vluncasu/via-oneplus-pad-terminal/docs/part-catalog.md

# Printable Part Catalog

Parts, quantities and filament groups for the R14.1 enclosure. Bounds are X × Y × Z in the **supplied STL print orientation**, not assembly dimensions. Numbers are rounded to two decimals. Quantity is the total copies of the one file; reference objects R01–R05 are excluded.

| Required color group | Unique files | Printed pieces |
|---|---:|---:|
| white PETG | 12 | 25 |
| black PETG | 4 | 4 |
| natural PETG | 1 | 1 |

## Required components

| IDs | Part / file | Copies | Filament | Supplied STL bounds (mm) |
|---|---|---:|---|---|
| B01 | [monoblock base integrated light belt](../hardware/print/white-petg/01x_B01_monoblock_base_integrated_light_belt.stl) | 1 | white PETG | 190.21 × 190.21 × 230.00 |
| B03 | [bottom service cover](../hardware/print/white-petg/01x_B03_bottom_service_cover.stl) | 1 | white PETG | 157.26 × 157.26 × 209.40 |
| B07 | [integrated s stand and power supply cover](../hardware/print/white-petg/01x_B07_integrated_s_stand_and_power_supply_cover.stl) | 1 | white PETG | 240.00 × 230.00 × 197.00 |
| P01 | [recessed dummy port cartridge and cable funnel](../hardware/print/black-petg/01x_P01_recessed_dummy_port_cartridge_and_cable_funnel.stl) | 1 | black PETG | 180.00 × 19.99 × 14.00 |
| H01 | [structural front frame integrated led channel](../hardware/print/white-petg/01x_H01_structural_front_frame_integrated_led_channel.stl) | 1 | white PETG | 242.75 × 242.75 × 224.00 |
| H04 | [lower structural rear cover](../hardware/print/white-petg/01x_H04_lower_structural_rear_cover.stl) | 1 | white PETG | 221.61 × 221.61 × 187.55 |
| O01 | [open optical carrier](../hardware/print/black-petg/01x_O01_open_optical_carrier.stl) | 1 | black PETG | 26.00 × 194.00 × 29.80 |
| O03 | [optical carrier usb service cover](../hardware/print/black-petg/01x_O03_optical_carrier_usb_service_cover.stl) | 1 | black PETG | 34.60 × 202.60 × 7.00 |
| V21, V22, V23, V24 | [head mount screw D12 P2p5 L12](../hardware/print/white-petg/04x_V21-V22-V23-V24_head_mount_screw_D12_P2p5_L12.stl) | 4 | white PETG | 18.71 × 18.72 × 16.00 |
| V31, V32, V33, V34 | [spherical slotted screw foot D8](../hardware/print/white-petg/04x_V31-V32-V33-V34_spherical_slotted_screw_foot_D8.stl) | 4 | white PETG | 23.23 × 23.23 × 20.00 |
| V41, V42, V43, V44 | [base cover screw D8 P2p5 L10](../hardware/print/white-petg/04x_V41-V42-V43-V44_base_cover_screw_D8_P2p5_L10.stl) | 4 | white PETG | 12.48 × 12.48 × 14.00 |
| V51, V52, V53, V54 | [rear cover screw D8 P2p5 L14](../hardware/print/white-petg/04x_V51-V52-V53-V54_rear_cover_screw_D8_P2p5_L14.stl) | 4 | white PETG | 12.48 × 12.48 × 18.00 |
| V61, V62 | [usb cover screw D8 P2p5 L16p3](../hardware/print/white-petg/02x_V61-V62_usb_cover_screw_D8_P2p5_L16p3.stl) | 2 | white PETG | 12.48 × 12.48 × 20.30 |
| H05 | [sliding top tablet retention bar](../hardware/print/white-petg/01x_H05_sliding_top_tablet_retention_bar.stl) | 1 | white PETG | 195.16 × 195.16 × 8.30 |
| O05 | [captive optical film 0p20mm](../hardware/print/natural-petg/01x_O05_captive_optical_film_0p20mm.stl) | 1 | natural PETG | 25.60 × 193.60 × 0.20 |
| H06 | [upper rear service cover integrated locking pins](../hardware/print/white-petg/01x_H06_upper_rear_service_cover_integrated_locking_pins.stl) | 1 | white PETG | 236.58 × 236.58 × 34.20 |
| O06 | [flat back dummy sensor face](../hardware/print/black-petg/01x_O06_flat_back_dummy_sensor_face.stl) | 1 | black PETG | 26.00 × 194.00 × 3.00 |

## Optional low-material probes

| IDs | Part / file | Copies | Filament | Supplied STL bounds (mm) |
|---|---|---:|---|---|
| Q12 | [usb plug pull through gauge 16x10x30](../hardware/print/optional-probes/01x_Q12_usb_plug_pull_through_gauge_16x10x30.stl) | 1 | white PETG | 16.00 × 10.00 × 30.00 |
| Q01 | [D12 thread test screw](../hardware/print/optional-probes/01x_Q01_D12_thread_test_screw.stl) | 1 | white PETG | 18.71 × 18.72 × 16.00 |
| Q02 | [D12 nut clearance 0p25](../hardware/print/optional-probes/01x_Q02_D12_nut_clearance_0p25.stl) | 1 | white PETG | 19.99 × 20.00 × 10.00 |
| Q03 | [D12 nut clearance 0p35](../hardware/print/optional-probes/01x_Q03_D12_nut_clearance_0p35.stl) | 1 | white PETG | 19.99 × 20.00 × 10.00 |
| Q04 | [D12 nut clearance 0p45](../hardware/print/optional-probes/01x_Q04_D12_nut_clearance_0p45.stl) | 1 | white PETG | 19.99 × 20.00 × 10.00 |
| Q05 | [D8 thread test screw](../hardware/print/optional-probes/01x_Q05_D8_thread_test_screw.stl) | 1 | white PETG | 12.48 × 12.48 × 14.00 |
| Q06 | [D8 nut clearance 0p30](../hardware/print/optional-probes/01x_Q06_D8_nut_clearance_0p30.stl) | 1 | white PETG | 13.99 × 14.00 × 8.00 |
| Q07 | [tablet corner fit coupon](../hardware/print/optional-probes/01x_Q07_tablet_corner_fit_coupon.stl) | 1 | white PETG | 30.00 × 30.00 × 9.00 |
| Q11 | [front camera clearance coupon](../hardware/print/optional-probes/01x_Q11_front_camera_clearance_coupon.stl) | 1 | white PETG | 40.00 × 17.89 × 8.30 |
| Q08 | [light transmission wall 0p6](../hardware/print/optional-probes/01x_Q08_light_transmission_wall_0p6.stl) | 1 | white PETG | 25.00 × 15.00 × 0.60 |
| Q09 | [light transmission wall 0p8](../hardware/print/optional-probes/01x_Q09_light_transmission_wall_0p8.stl) | 1 | white PETG | 25.00 × 15.00 × 0.80 |
| Q10 | [light transmission wall 1p0](../hardware/print/optional-probes/01x_Q10_light_transmission_wall_1p0.stl) | 1 | white PETG | 25.00 × 15.00 × 1.00 |
| Q13 | [tablet width gauge 259p03](../hardware/print/optional-probes/01x_Q13_tablet_width_gauge_259p03.stl) | 1 | white PETG | 200.13 × 200.13 × 11.00 |
| Q14 | [tablet height gauge 190p41](../hardware/print/optional-probes/01x_Q14_tablet_height_gauge_190p41.stl) | 1 | white PETG | 151.61 × 151.61 × 11.00 |
| Q15 | [led channel corner coupon 8p5](../hardware/print/optional-probes/01x_Q15_led_channel_corner_coupon_8p5.stl) | 1 | white PETG | 29.00 × 24.00 × 14.00 |

## Alternatives and reference envelopes

O05 0.40 mm is an optional replacement for the 0.20 mm default, not an extra required piece. R01 tablet, R02 supply, R03 USB plug and R04/R05 LED volumes are inspection references, not printable hardware.

White PETG: structural pieces and printed fasteners. Black PETG: P01, O01, O03 and O06. Natural PETG: O05. The present rigid feet are not TPU pads.

## Reading the file families

- B: base / stand and service enclosure.
- H: structural head and tablet retention.
- O: optical cassette, service cover, sensor face and film.
- P: one-piece dummy port cartridge.
- V: printed screw / foot instances.
- Q: optional fit and process probes.
- R: reference envelopes, never a print quantity.

Use [fasteners and service](fasteners-and-service.md) for the receiving interface of each V family, [manufacturing workflow](manufacturing-workflow.md) before large prints, and [assembly](assembly.md) for the build order.

This catalog is a file-selection aid. Its bounds and closed-mesh results do not qualify strength, fit, supports or optical performance.
