vluncasu/via-oneplus-pad-terminal/docs/references.md

# Sources and Attribution

Project-specific dimensions come from the delivered R14 CAD/print inventory unless explicitly identified as a manufacturer specification or provisional envelope.

1. [OnePlus Pad specifications](https://www.oneplus.com/ca_en/oneplus-pad/specs): nominal tablet body dimensions. This project is not affiliated with OnePlus.
2. [Bambu Lab P1 series technical specifications](https://bambulab.com/en/p1/tech-specs) and [print-volume limitations](https://wiki.bambulab.com/en/knowledge-sharing/print-volume-limitations): nominal build volume and practical exclusions; availability can vary by region.
3. [Android Bluetooth permissions](https://developer.android.com/develop/connectivity/bluetooth/bt-permissions): runtime permissions and Android-version differences.
4. [MediaPipe Hand Landmarker](https://developers.google.com/edge/mediapipe/solutions/vision/hand_landmarker): hand landmarks and handedness; not proof of financial identity.
5. [MediaPipe Hands paper](https://arxiv.org/abs/2006.10214): pipeline context.
6. [ML Kit face detection concepts](https://developers.google.com/ml-kit/vision/face-detection/face-detection-concepts): face features, classification and tracking context.
7. [MediaPipe license](https://github.com/google-ai-edge/mediapipe/blob/master/LICENSE), [Android/ML Kit terms](https://developers.google.com/ml-kit/terms), and the notices of each dependency apply independently.

The repository consolidates the project source, design artifacts and scoped verification evidence. The design rationale is a prototype engineering report, not a published experimental study; it does not claim a DOI, institutional certification or unmeasured performance. Attribution is to VIA project contributors and the repository owner, vluncasu.
