vluncasu/via-oneplus-pad-terminal/docs/gallery-engineering.md

# Internal Structure, Assembly and Service Views

All figures use the supplied actual component meshes. Materials and intended LED emission are illustrative. Orange objects are non-printable reference envelopes. Covers omitted and section cuts are stated per figure; they do not alter the STL files. The normal [assembled Blender scene](../media/via-oneplus-pad-r14-1-assembled.blend) remains separate.

[Gallery index](gallery.md) · [Documentation](README.md)

## Figure 04 — Base body and recessed ports

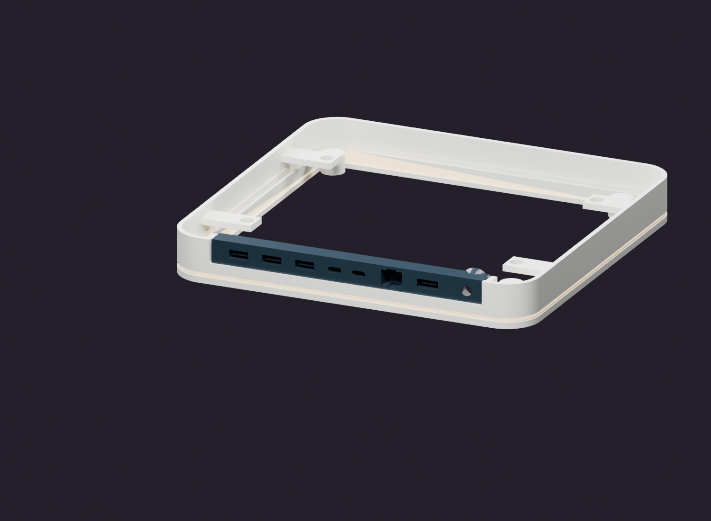
[picture p11: media/renders/04-recessed-dummy-usb-ethernet-ports.png]
Base body and recessed ports


B01 and P01 only; upper cover/stand omitted to show how the cartridge sits within the outer base.

## Figure 06 — Upper retention bar and service cover

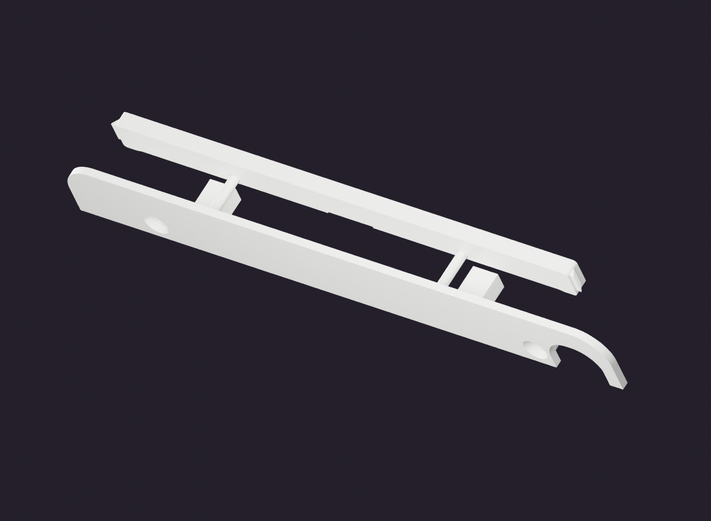
[picture p12: media/renders/06-top-service-locking-bar.png]
Upper retention bar and service cover


H05/H06 isolated at their assembled positions. The integrated pins belong to H06; there is no loose miniature lock pin.

## Figure 07 — Integrated head LED channel

Integrated head LED channel

H01 with R05 orange reserved LED volume. The orange object is not a printable strip or a verified bend solution.

## Figure 08 — Integrated base LED channel

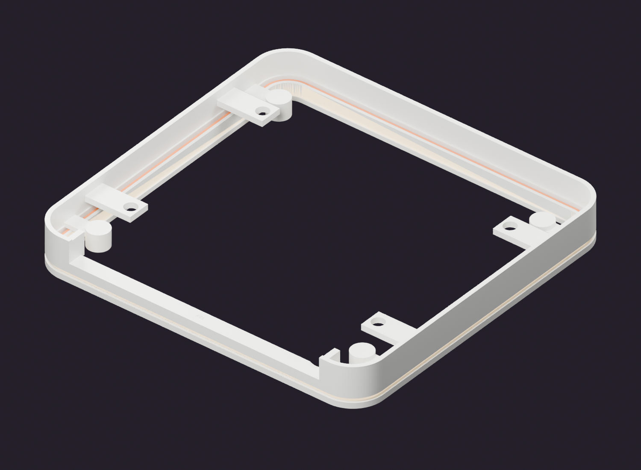
[picture p13: media/renders/08-integrated-base-led-channel.png]
Integrated base LED channel


B01 with R04 orange reserved LED volume; integrated seating and rim geometry are visible.

## Figure 09 — Stand-root underside

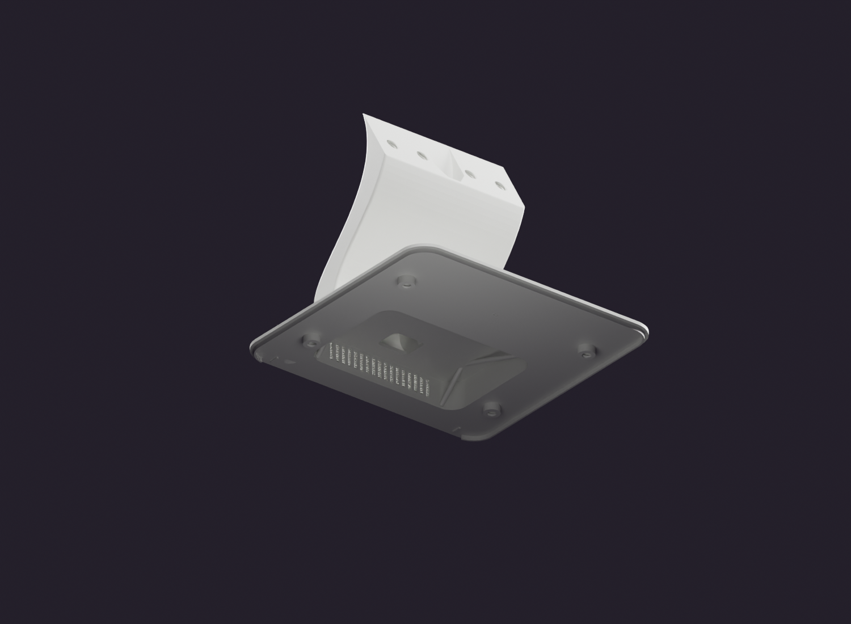
[picture p14: media/renders/09-stand-root-reinforcement.png]
Stand-root underside


B07 viewed from below with inspection fill lighting; cover, duct opening and root material are the actual supplied shape.

## Figure 10 — Internal cable duct section

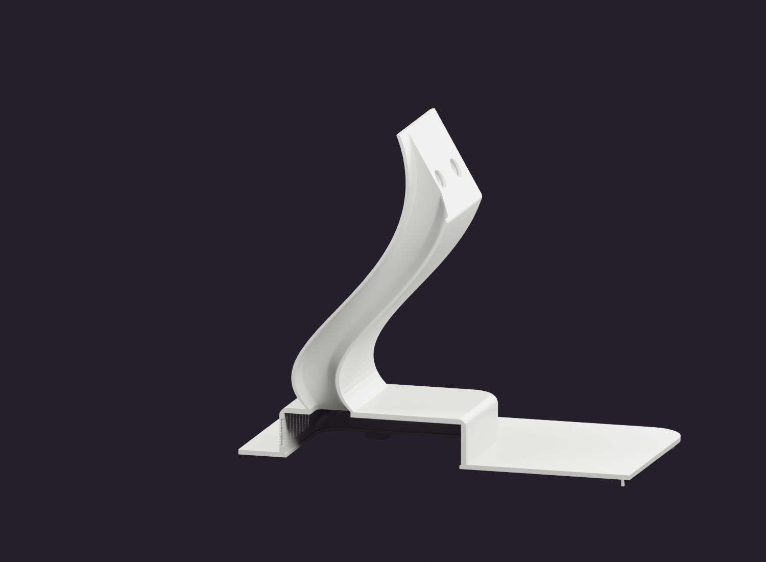
[picture p15: media/renders/10-internal-cable-duct-section.png]
Internal cable duct section


One side of B07 is removed only for this inspection view. The printable stand remains a single piece.

## Figure 20 — Head with rear covers omitted

Head with rear covers omitted

H01, nominal R01 tablet envelope, optical parts, H05 and head screws remain. H04/H06 omitted for seating inspection.

## Figure 21 — Rear covers and top restraint

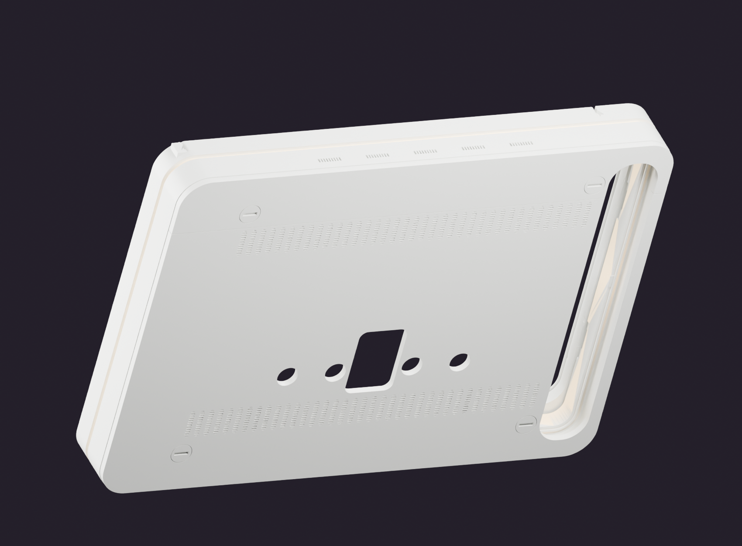
[picture p16: media/renders/21-rear-cover-and-retention-assembly.png]
Rear covers and top restraint


H01/H04/H05/H06 with rear screws in assembly coordinates. Tablet and optical cassette omitted.

## Figure 22 — Base underside and supply envelope

Base underside and supply envelope

B01/B07/P01 with orange R02 body envelope; bottom service cover omitted. R02 is not a detailed supply or a clearance qualification.

## Figure 23 — Stand root beside supply envelope

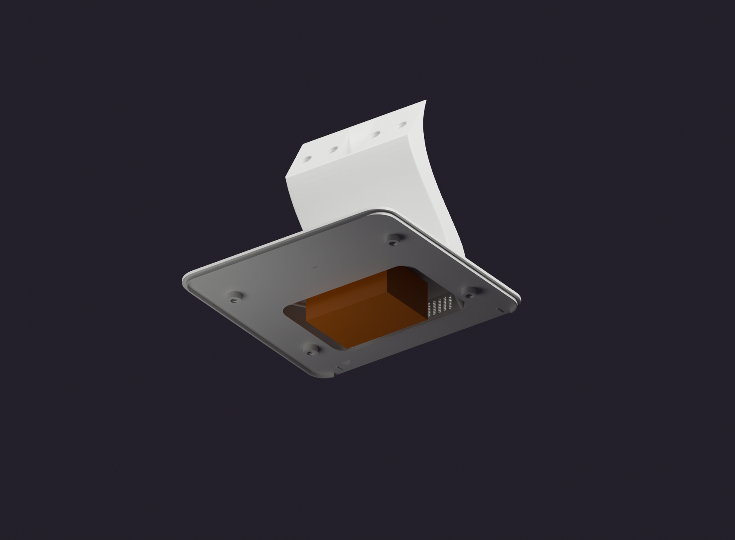
[picture p17: media/renders/23-stand-root-supply-clearance.png]
Stand root beside supply envelope


B07 and orange R02 only. The root braces belong to the stand, not the supply. Terminal/wiring/cooling clearance still needs the real component.

## Figure 24 — Bottom service cover, screws and feet

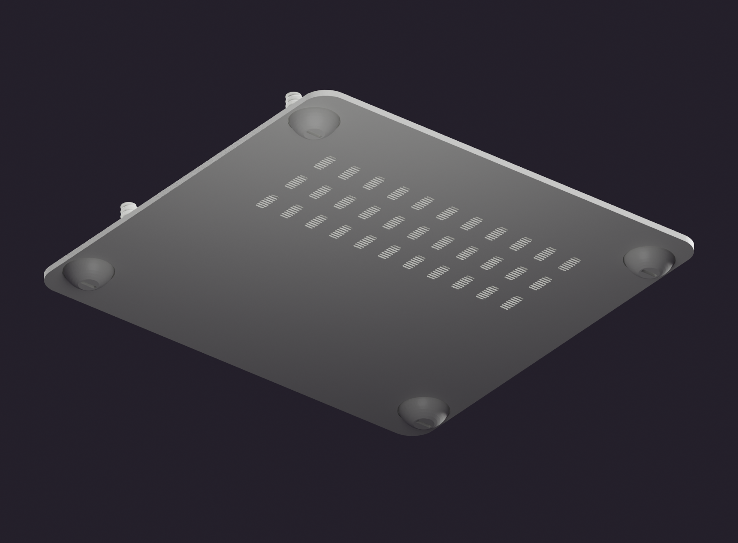
[picture p18: media/renders/24-bottom-service-cover-fasteners.png]
Bottom service cover, screws and feet


B03 with V41–V44 and V31–V34 in their assembled positions; base and upper cover omitted.

## Figure 29 — Tablet retention components

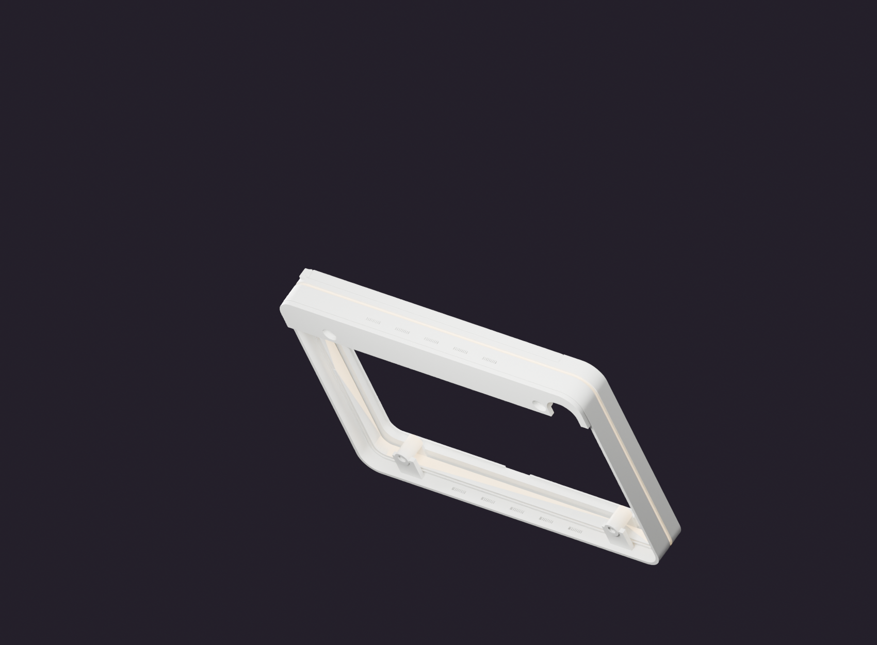
[picture p19: media/renders/29-tablet-retention-interface.png]
Tablet retention components


H01/H05/H06 isolated in assembly coordinates to relate the guide bar to the upper service cover.

## Figure 30 — Opposite stand-duct section

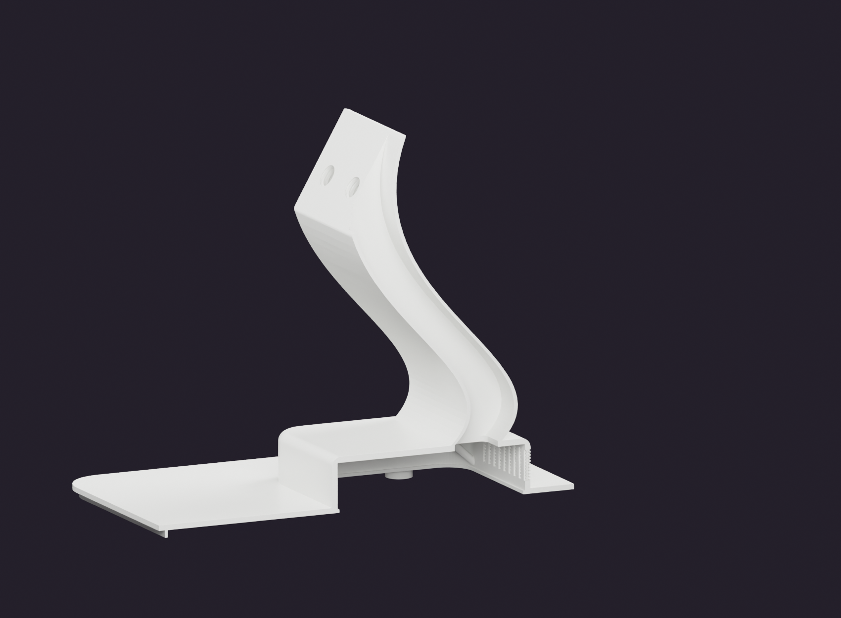
[picture p20: media/renders/30-cable-duct-opposite-section.png]
Opposite stand-duct section


Opposite half-section of B07. This inspection-only subtraction is not part of the manufacturing files.

## Figure 31 — Structural head from the front

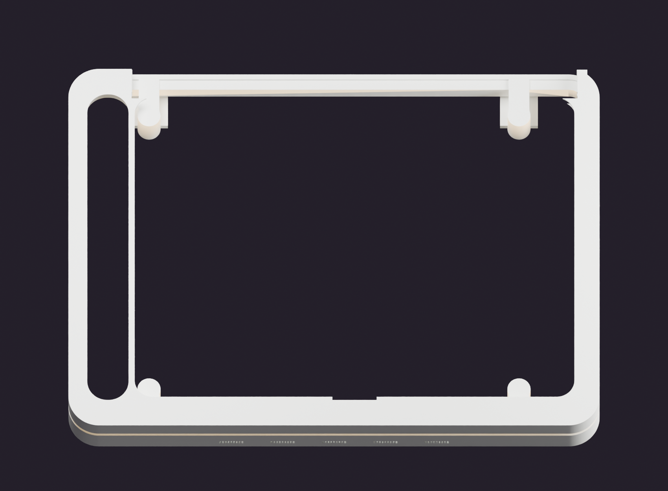
[picture p21: media/renders/31-head-structure-front-camera-region.png]
Structural head from the front


H01 alone, including structural opening and upper camera region. Actual camera field of view must be checked on the tablet.

## Figure 32 — Rear ventilation and cover split

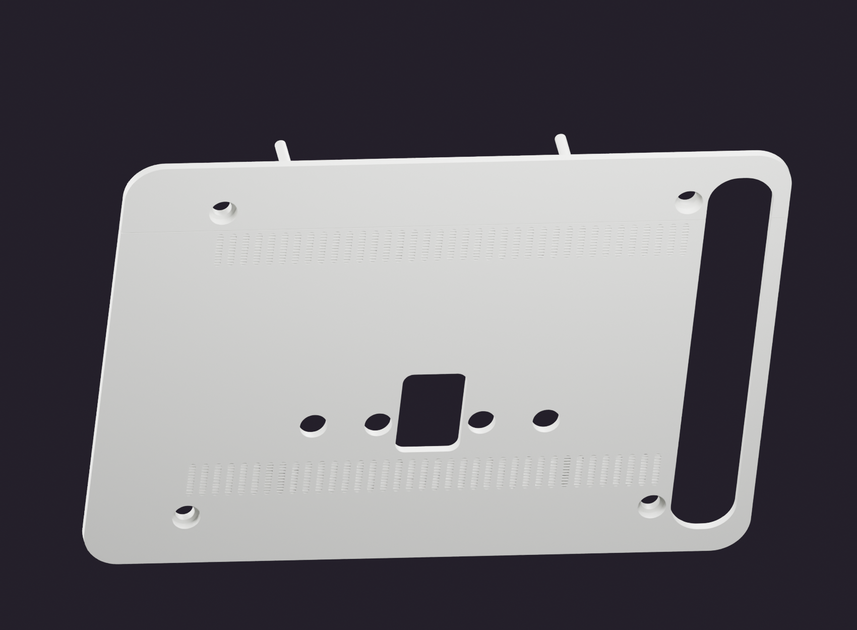
[picture p22: media/renders/32-symmetric-rear-ventilation.png]
Rear ventilation and cover split


H04/H06 only, with repeated vent pattern and the upper/lower service split visible. Airflow and filtration are not quantified.
