vluncasu/via-oneplus-pad-terminal/hardware/cad/authoring-history/Terminal_OPD2203_R01/cad/Terminal_OPD2203_R01.FCStd

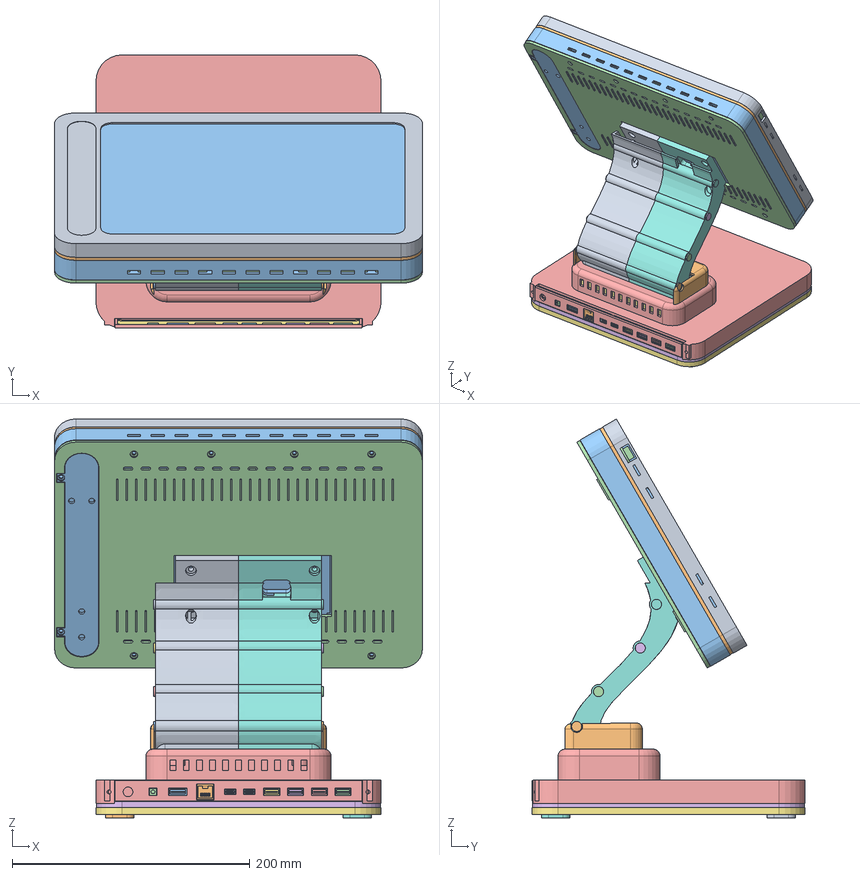
[picture p38: CAD file, 2026-11-08]
hardware/cad/authoring-history/Terminal_OPD2203_R01/cad/Terminal_OPD2203_R01.FCStd
310.0 x 230.0 x 335.9 mm
H01 — Rama frontala, suport PCB LED
H02 — Difuzor cap monobloc
H03 — Cochilie structurala cu traversa cap-picior
H04 — Capac posterior ventilat cu nervuri fine
H11 — Opritor tableta 1
T11 — Tampon retentie TPU 1
H12 — Opritor tableta 2
T12 — Tampon retentie TPU 2
H13 — Opritor tableta 3
T13 — Tampon retentie TPU 3
H14 — Opritor tableta 4
T14 — Tampon retentie TPU 4
T21 — Tampon lateral TPU 1
T22 — Tampon lateral TPU 2
T23 — Tampon lateral TPU 3
T24 — Tampon lateral TPU 4
O01 — Fata optica PMMA transparent
O02 — Masca optica neagra
O03 — Caseta optica si capac service
O04 — Leagan OV2659 schimbabil
O05 — Agrafa camera 1
O06 — Agrafa camera 2
O07 — Obiectiv decorativ in trepte cu tija M2
O08 — Insert optic mic decorativ cu tija M2
O11 — Inel concentric optic 1
O12 — Inel concentric optic 2
O09 — Clema cablu USB, strangere pe mantaua cablului
H20 — Actuator Power de proba
B01 — Baza tehnica cu volum local pentru sursa
B02 — Difuzor baza monobloc
B03 — Capac inferior, admisie si ancorare
T31 — Picior TPU 1
T32 — Picior TPU 2
T33 — Picior TPU 3
T34 — Picior TPU 4
P01 — USB-A decorativ cu fund inchis
P02 — USB-A decorativ cu fund inchis
P03 — USB-A decorativ cu fund inchis
P04 — USB-A decorativ cu fund inchis
P05 — USB-C decorativ cu fund inchis
P06 — USB-C decorativ cu fund inchis
P07 — RJ45 decorativ cu fund inchis
P08 — HDMI decorativ cu fund inchis
P09 — AUDIO decorativ cu fund inchis
B04 — Panou I/O extins: 9 porturi false + DC real
B05 — Tava sursa parametric neconfirmata
B06 — Tava convertor si distributie
S01 — Picior S jumatate stanga cu traseu cablu
S02 — Picior S jumatate dreapta demontabila
S11L — Capac acces surub picior
S11R — Capac acces surub picior
S12L — Capac acces surub picior
S12R — Capac acces surub picior
S13L — Capac acces surub picior
S13R — Capac acces surub picior
S14L — Capac acces surub picior
S14R — Capac acces surub picior
B07 — Carenaj radacina demontabil, acces suruburi
R01 — OnePlus Pad corp oficial / colt ipoteza
R02 — Camera originala volum rezervat neconfirmat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
