vluncasu/via-oneplus-pad-terminal/hardware/cad/authoring-history/Terminal_OPD2203_R07/cad/Terminal_OPD2203_R07.FCStd

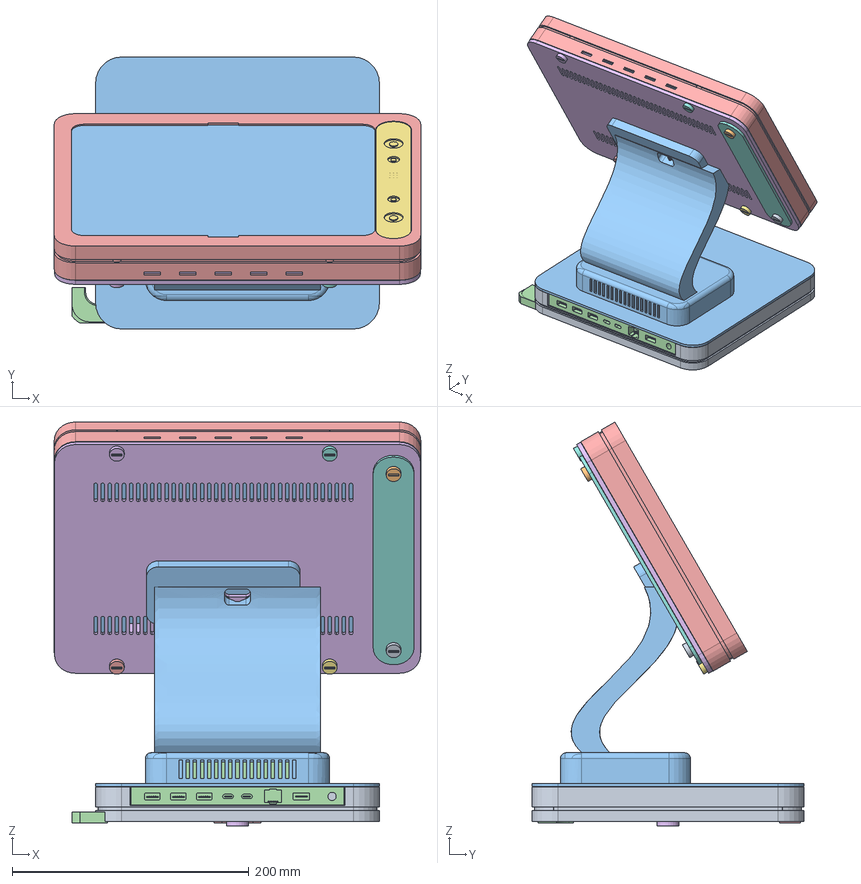
[picture p40: CAD file, 2026-11-08]
hardware/cad/authoring-history/Terminal_OPD2203_R07/cad/Terminal_OPD2203_R07.FCStd
310.0 x 230.0 x 341.6 mm
B01 Baza monobloc cu lumina integrata si talpi rigide
B03 Capac service inferior
B07 Capac sursa si picior S integrate monobloc
P01 Bloc unic porturi dummy cu palnie cablu
H01 Cap monobloc rama structura si zona luminoasa
H04 Capac structural posterior cu opritoare tableta
O01 Masca si caseta optica monobloc cu senzori dummy
O03 Capac service USB al casetei optice
V21 Surub imprimat D12 P2.5 L12 cap
V22 Surub imprimat D12 P2.5 L12 cap
V23 Surub imprimat D12 P2.5 L12 cap
V24 Surub imprimat D12 P2.5 L12 cap
V31 Surub imprimat D8 P2.5 L12 service
V32 Surub imprimat D8 P2.5 L12 service
V33 Surub imprimat D8 P2.5 L12 service
V34 Surub imprimat D8 P2.5 L12 service
V41 Surub imprimat D8 P2.5 L10 capac baza
V42 Surub imprimat D8 P2.5 L10 capac baza
V43 Surub imprimat D8 P2.5 L10 capac baza
V44 Surub imprimat D8 P2.5 L10 capac baza
V51 Surub imprimat capac posterior
V52 Surub imprimat capac posterior
V53 Surub imprimat capac posterior
V54 Surub imprimat capac posterior
V61 Surub imprimat capac posterior
V62 Surub imprimat capac posterior
R01 Tableta OPD2203 referinta
R02 Sursa rezerva dimensionala
R03 USB-C cotit rezerva de verificat
Q01 Surub proba D12 pas2.5
Q02 Piulita proba joc 0.25
Q03 Piulita proba joc 0.35
Q04 Piulita proba joc 0.45
Q05 Surub proba D8 pas2.5
Q06 Piulita proba D8 joc0.3
Q07 Microcolt integrare tableta
Q11 Proba degajare camera frontala
Q08 Proba transmisie perete 0.6
Q09 Proba transmisie perete 0.8
Q10 Proba transmisie perete 1.0
