vluncasu/via-oneplus-pad-terminal/hardware/cad/native/VIA_Terminal_R14_1_Editable.FCStd

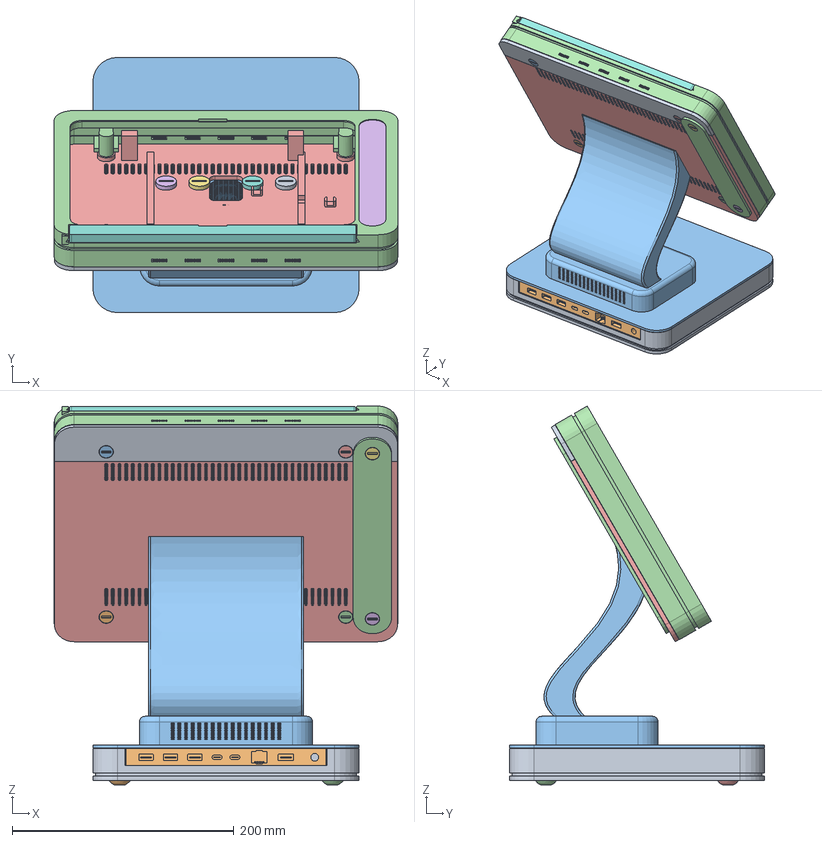
[picture p42: CAD file, 2026-11-08]
hardware/cad/native/VIA_Terminal_R14_1_Editable.FCStd
310.0 x 230.0 x 341.6 mm
B01 monoblock base integrated light belt
B03 bottom service cover
B07 integrated s stand and power supply cover
H01 structural front frame integrated led channel
H04 lower structural rear cover
V21 head mount screw D12 P2p5 L12
V22 head mount screw D12 P2p5 L12
V23 head mount screw D12 P2p5 L12
V24 head mount screw D12 P2p5 L12
V31 spherical slotted screw foot D8
V32 spherical slotted screw foot D8
V33 spherical slotted screw foot D8
V34 spherical slotted screw foot D8
V41 base cover screw D8 P2p5 L10
V42 base cover screw D8 P2p5 L10
V43 base cover screw D8 P2p5 L10
V44 base cover screw D8 P2p5 L10
V51 rear cover screw D8 P2p5 L14
V52 rear cover screw D8 P2p5 L14
V53 rear cover screw D8 P2p5 L14
V54 rear cover screw D8 P2p5 L14
V61 usb cover screw D8 P2p5 L16p3
V62 usb cover screw D8 P2p5 L16p3
H05 sliding top tablet retention bar
H06 upper rear service cover integrated locking pins
P01 recessed dummy port cartridge and cable funnel
O01 open optical carrier
O03 optical carrier usb service cover
O06 flat back dummy sensor face
O05 captive optical film 0.20 mm
