vluncasu/via-oneplus-pad-terminal/hardware/cad/references/R05_head_led_strip_reference_envelope.step

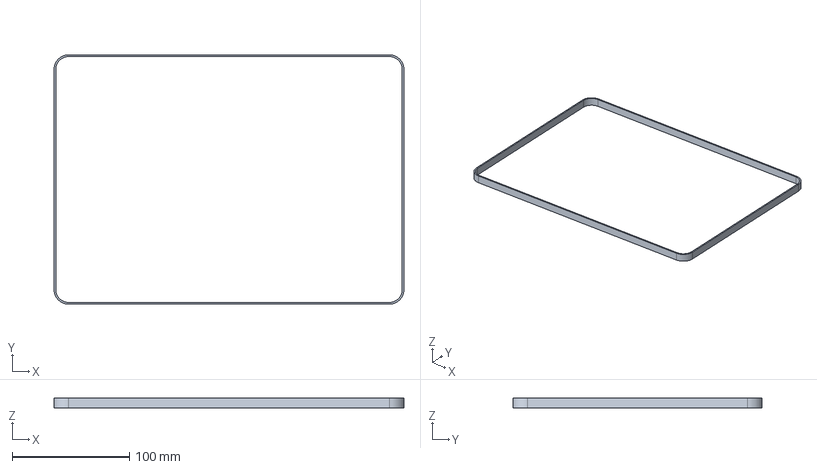
[picture p43: CAD file, 2026-11-08]
hardware/cad/references/R05_head_led_strip_reference_envelope.step
299.0 x 213.0 x 8.50 mm
