vluncasu/via-oneplus-pad-terminal/hardware/cad/step/alternative-thickness/O05_captive_optical_film_0p40mm_baseline.step

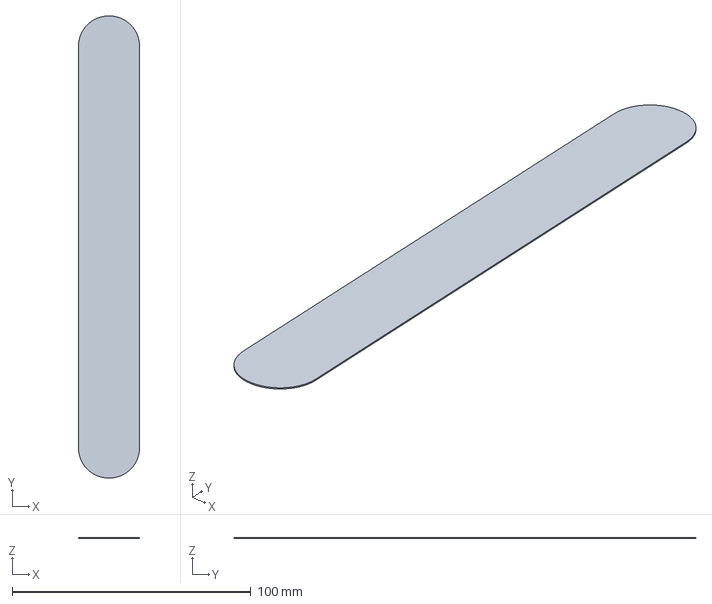
[picture p44: CAD file, 2026-11-08]
hardware/cad/step/alternative-thickness/O05_captive_optical_film_0p40mm_baseline.step
25.6 x 193.6 x 0.4 mm
