vluncasu/via-oneplus-pad-terminal/hardware/cad/step/optional-probes/Q07_tablet_corner_fit_coupon.step

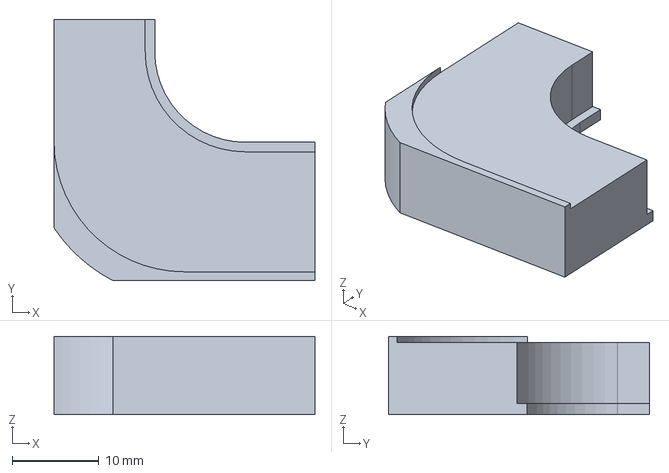
[picture p45: CAD file, 2026-11-08]
hardware/cad/step/optional-probes/Q07_tablet_corner_fit_coupon.step
30.0 x 30.0 x 9.00 mm
