vluncasu/via-oneplus-pad-terminal/hardware/print/black-petg/01x_O01_open_optical_carrier.stl

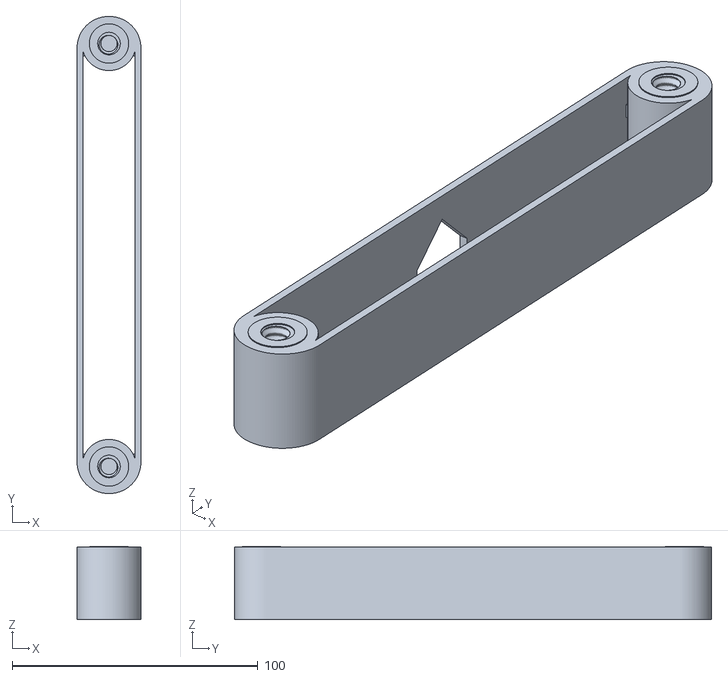
[picture p46: CAD file, 2026-11-08]
hardware/print/black-petg/01x_O01_open_optical_carrier.stl
26.0 x 194.0 x 29.8
