vluncasu/via-oneplus-pad-terminal/hardware/print/natural-petg/01x_O05_captive_optical_film_0p20mm.stl

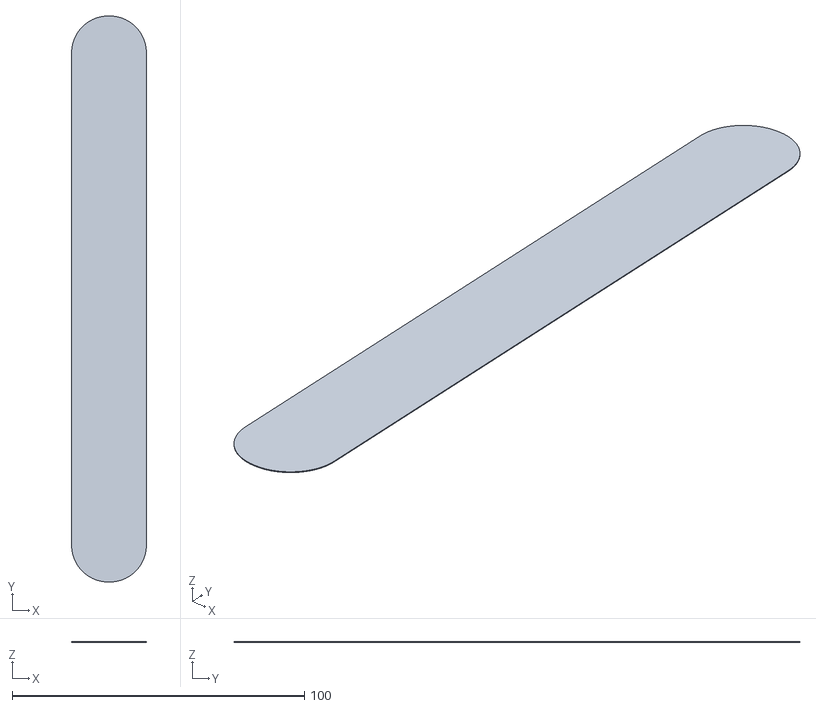
[picture p47: CAD file, 2026-11-08]
hardware/print/natural-petg/01x_O05_captive_optical_film_0p20mm.stl
25.6 x 193.6 x 0.2
