vluncasu/via-oneplus-pad-terminal/hardware/print/white-petg/01x_B03_bottom_service_cover.stl

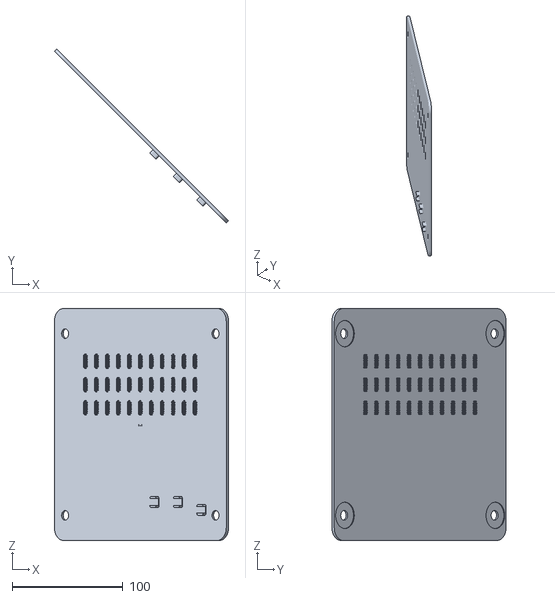
[picture p48: CAD file, 2026-11-08]
hardware/print/white-petg/01x_B03_bottom_service_cover.stl
157.3 x 157.3 x 209.4
