vluncasu/via-oneplus-pad-terminal/hardware/cad/references/R02_power_supply_reference_envelope.step

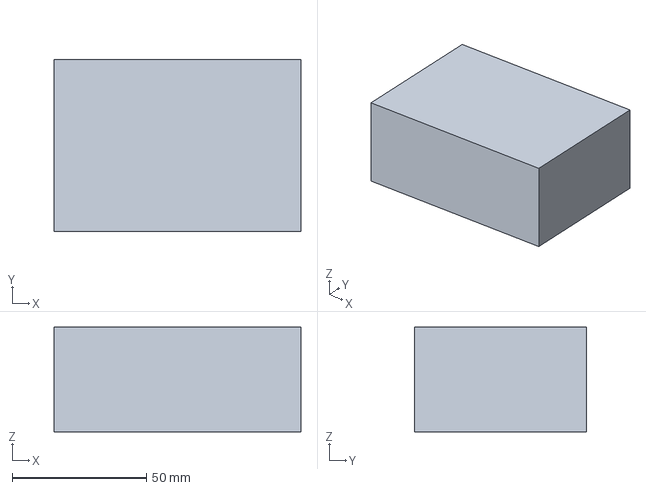
[picture p49: CAD file, 2026-11-08]
hardware/cad/references/R02_power_supply_reference_envelope.step
92.0 x 64.0 x 39.0 mm
