vluncasu/via-oneplus-pad-terminal/hardware/print/black-petg/01x_O06_flat_back_dummy_sensor_face.stl

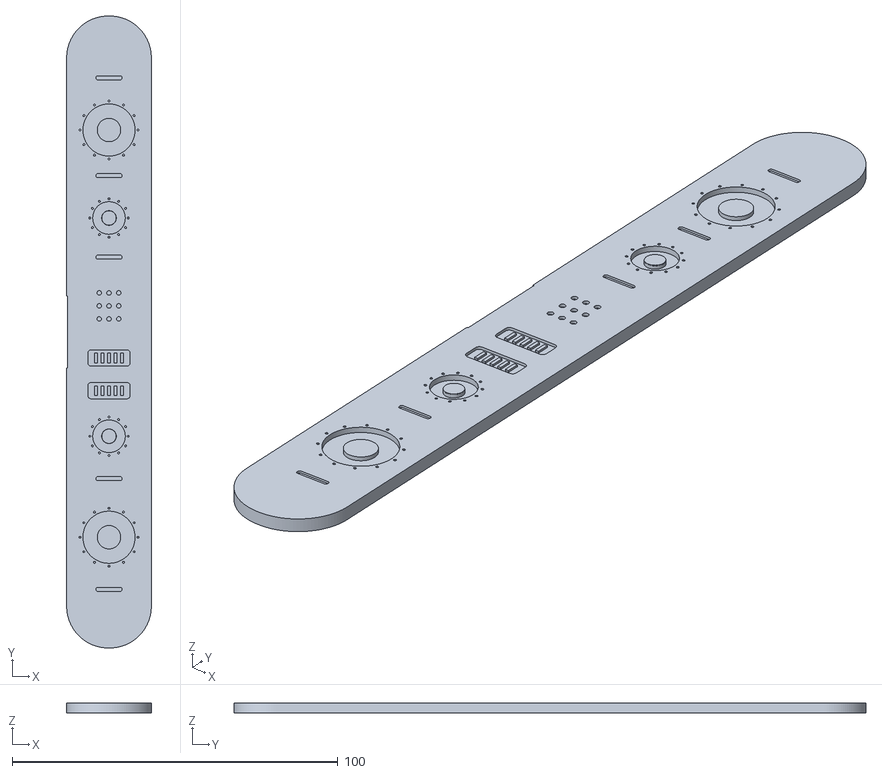
[picture p50: CAD file, 2026-11-08]
hardware/print/black-petg/01x_O06_flat_back_dummy_sensor_face.stl
26.0 x 194.0 x 3.00
