vluncasu/via-oneplus-pad-terminal/hardware/cad/references/R03_right_angle_usb_plug_reference.step

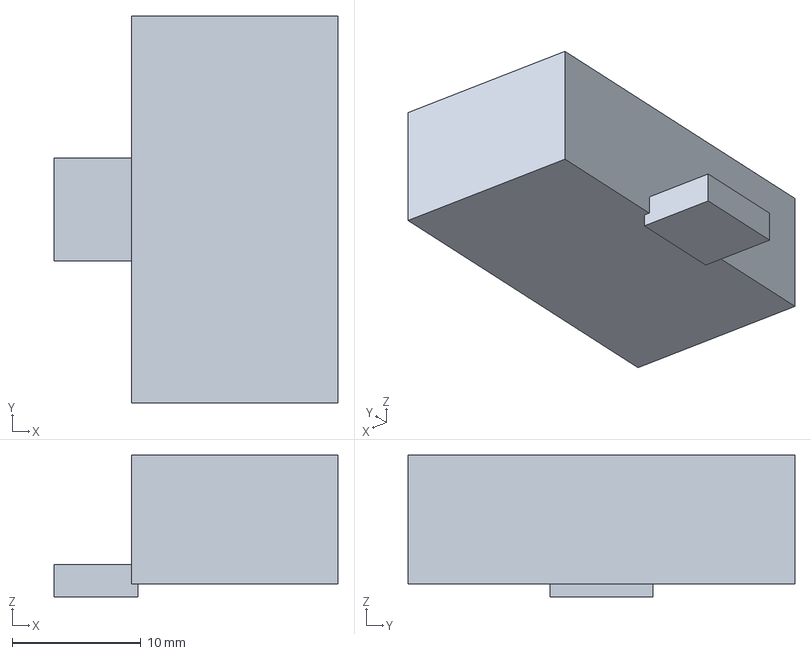
[picture p51: CAD file, 2026-11-08]
hardware/cad/references/R03_right_angle_usb_plug_reference.step
22.0 x 30.0 x 11.0 mm
