vluncasu/via-oneplus-pad-terminal/hardware/cad/step/B07_integrated_s_stand_and_power_supply_cover.step

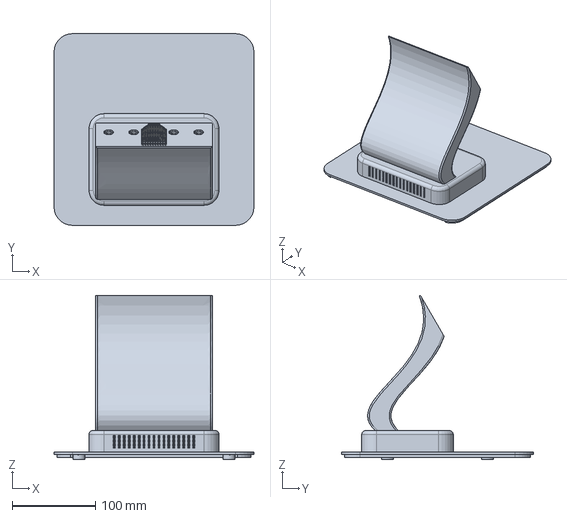
[picture p52: CAD file, 2026-11-08]
hardware/cad/step/B07_integrated_s_stand_and_power_supply_cover.step
240.0 x 230.0 x 197.0 mm
