vluncasu/via-oneplus-pad-terminal/hardware/print/black-petg/01x_O03_optical_carrier_usb_service_cover.stl

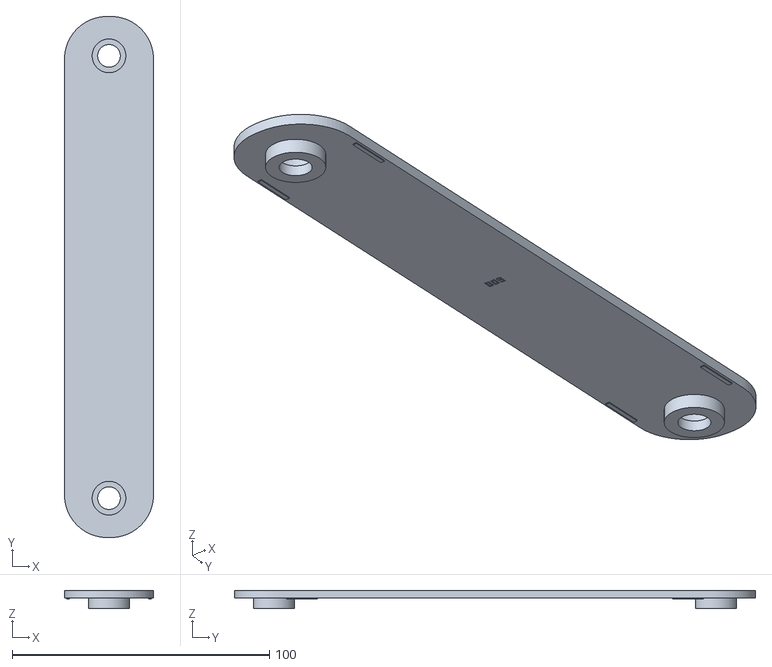
[picture p53: CAD file, 2026-11-08]
hardware/print/black-petg/01x_O03_optical_carrier_usb_service_cover.stl
34.6 x 202.6 x 7.00
