vluncasu/via-oneplus-pad-terminal/hardware/print/white-petg/01x_B01_monoblock_base_integrated_light_belt.stl

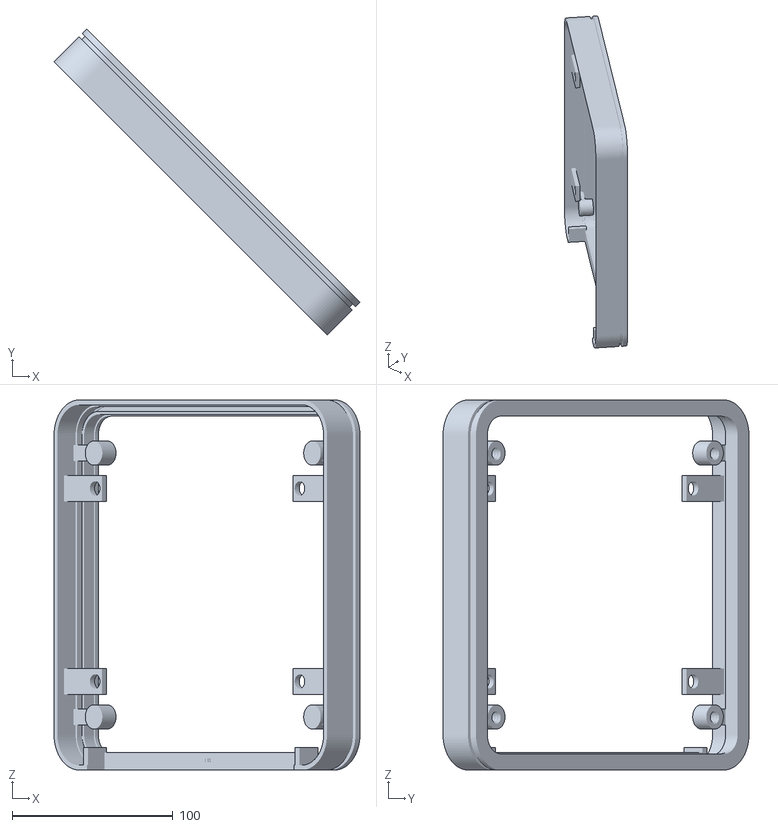
[picture p54: CAD file, 2026-11-08]
hardware/print/white-petg/01x_B01_monoblock_base_integrated_light_belt.stl
190.2 x 190.2 x 230.0
