vluncasu/via-oneplus-pad-terminal/hardware/cad/references/R04_base_led_strip_reference_envelope.step

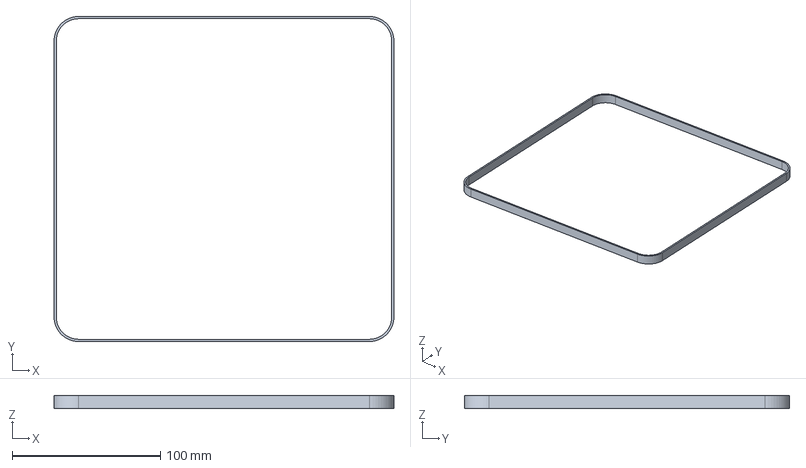
[picture p55: CAD file, 2026-11-08]
hardware/cad/references/R04_base_led_strip_reference_envelope.step
229.0 x 219.0 x 8.50 mm
