vluncasu/via-oneplus-pad-terminal/hardware/print/black-petg/01x_P01_recessed_dummy_port_cartridge_and_cable_funnel.stl

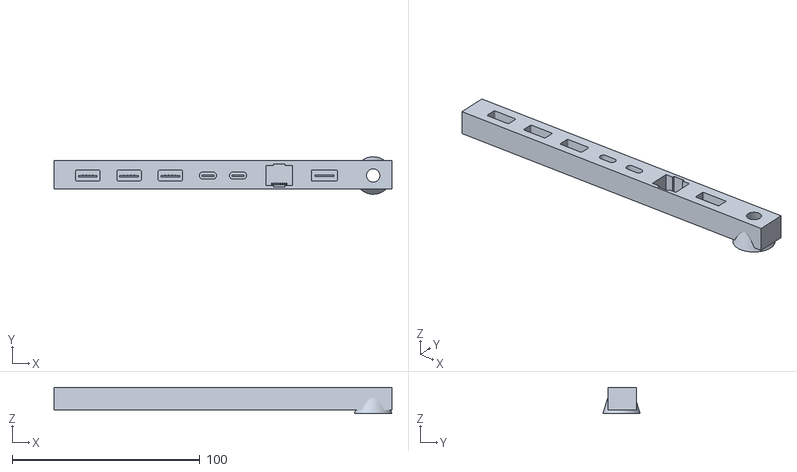
[picture p56: CAD file, 2026-11-08]
hardware/print/black-petg/01x_P01_recessed_dummy_port_cartridge_and_cable_funnel.stl
180.0 x 20.0 x 14.0
