vluncasu/via-oneplus-pad-terminal/hardware/cad/references/R01_tablet_reference_envelope.step

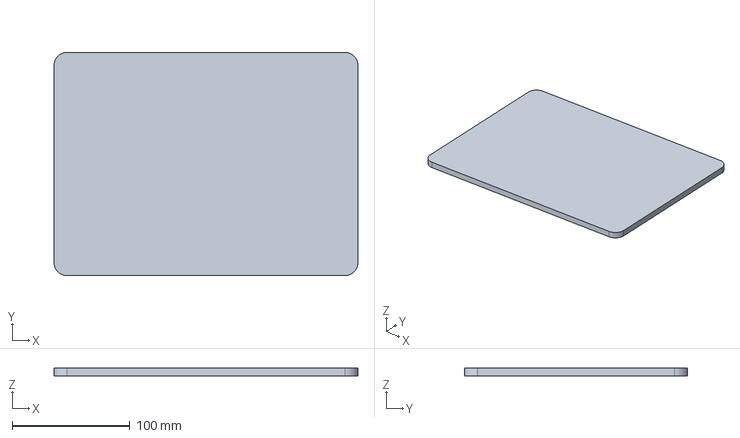
[picture p57: CAD file, 2026-11-08]
hardware/cad/references/R01_tablet_reference_envelope.step
258.0 x 189.4 x 6.54 mm
