vluncasu/via-oneplus-pad-terminal/hardware/cad/step/optional-probes/Q15_led_channel_corner_coupon_8p5.step

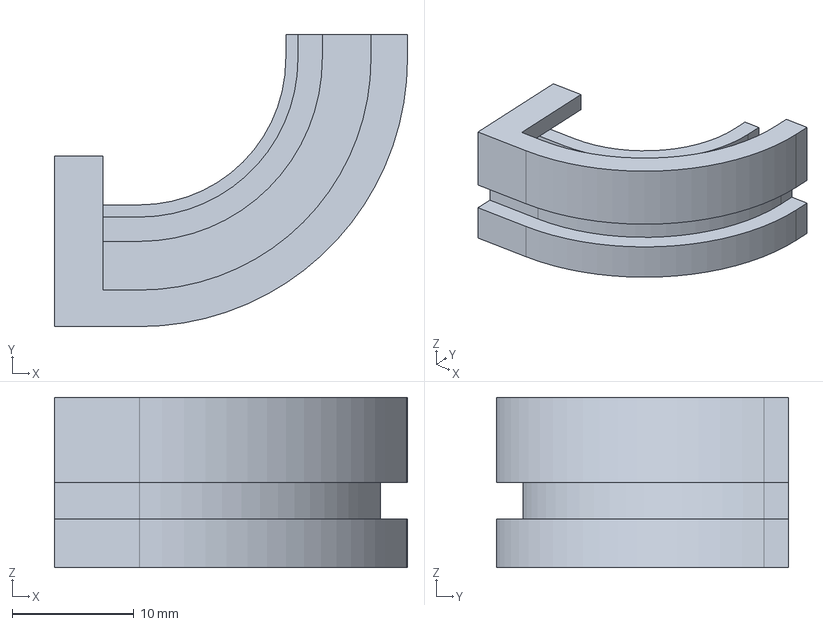
[picture p58: CAD file, 2026-11-08]
hardware/cad/step/optional-probes/Q15_led_channel_corner_coupon_8p5.step
29.0 x 24.0 x 14.0 mm
