vluncasu/via-oneplus-pad-terminal/hardware/print/optional-probes/01x_Q12_usb_plug_pull_through_gauge_16x10x30.stl

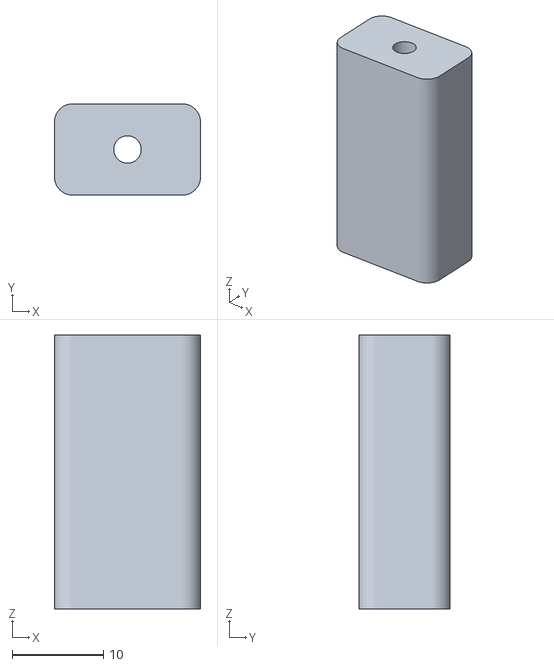
[picture p59: CAD file, 2026-11-08]
hardware/print/optional-probes/01x_Q12_usb_plug_pull_through_gauge_16x10x30.stl
16.0 x 10.0 x 30.0
