vluncasu/via-oneplus-pad-terminal/hardware/print/white-petg/01x_H04_lower_structural_rear_cover.stl

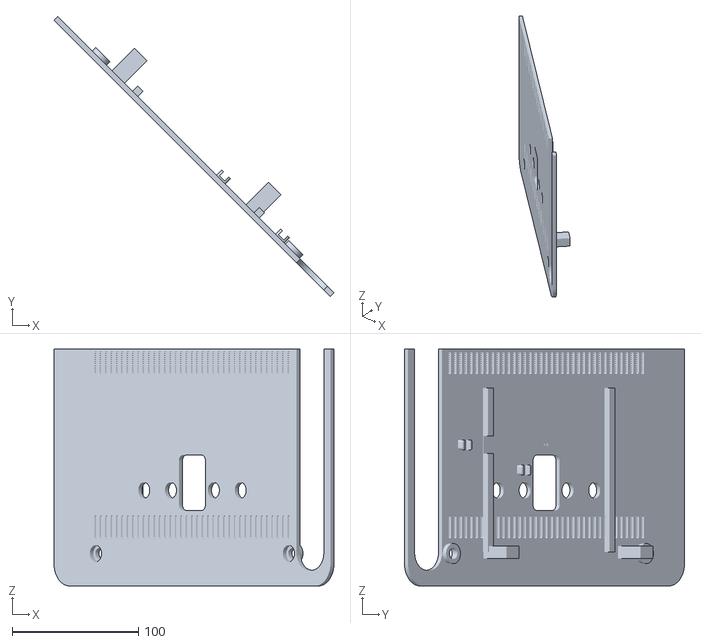
[picture p60: CAD file, 2026-11-08]
hardware/print/white-petg/01x_H04_lower_structural_rear_cover.stl
221.6 x 221.6 x 187.6
