vluncasu/via-oneplus-pad-terminal/hardware/print/white-petg/01x_H05_sliding_top_tablet_retention_bar.stl

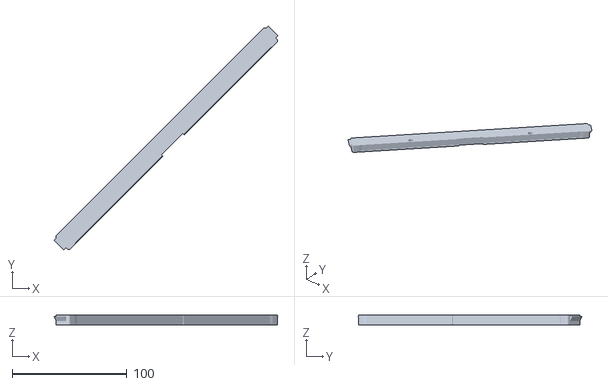
[picture p61: CAD file, 2026-11-08]
hardware/print/white-petg/01x_H05_sliding_top_tablet_retention_bar.stl
195.2 x 195.2 x 8.30
