vluncasu/via-oneplus-pad-terminal/hardware/cad/step/H01_structural_front_frame_integrated_led_channel.step

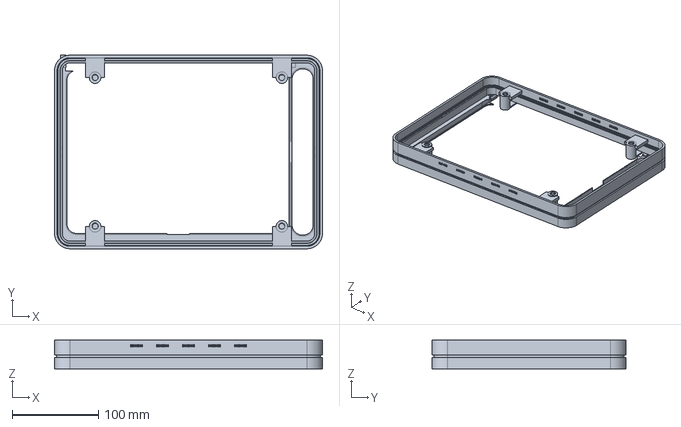
[picture p62: CAD file, 2026-11-08]
hardware/cad/step/H01_structural_front_frame_integrated_led_channel.step
310.0 x 224.0 x 33.3 mm
