vluncasu/via-oneplus-pad-terminal/hardware/print/white-petg/01x_H01_structural_front_frame_integrated_led_channel.stl

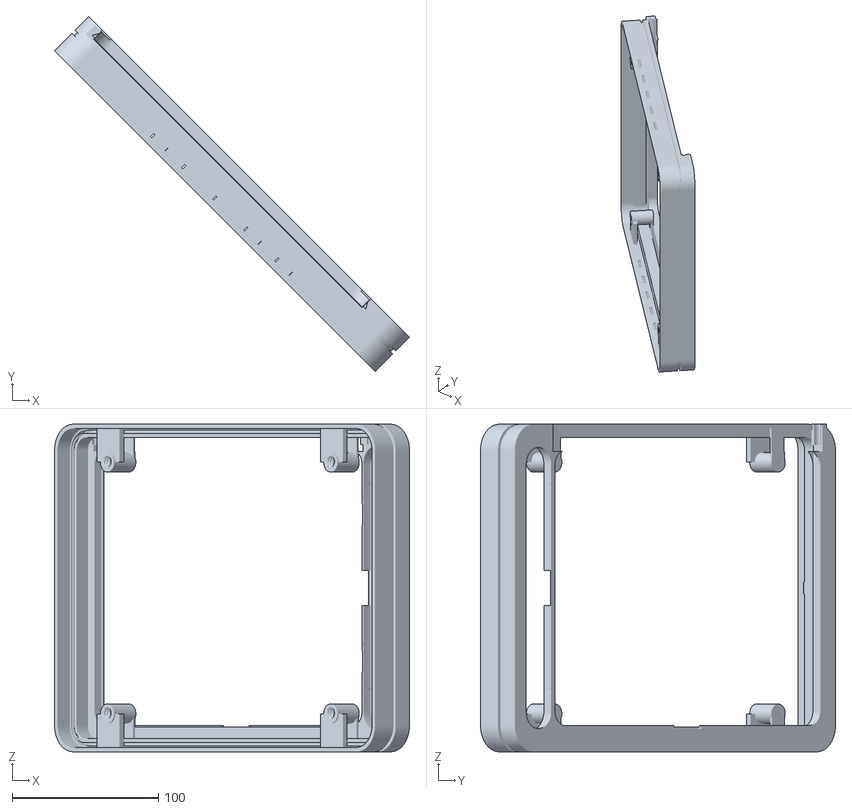
[picture p63: CAD file, 2026-11-08]
hardware/print/white-petg/01x_H01_structural_front_frame_integrated_led_channel.stl
242.7 x 242.7 x 224.0
