vluncasu/via-oneplus-pad-terminal/hardware/cad/step/optional-probes/Q13_tablet_width_gauge_259p03.step

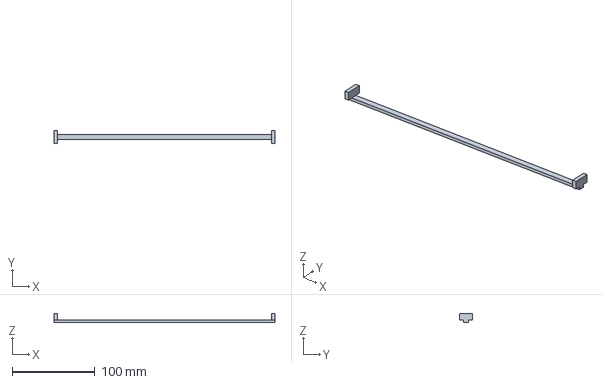
[picture p64: CAD file, 2026-11-08]
hardware/cad/step/optional-probes/Q13_tablet_width_gauge_259p03.step
267.0 x 16.0 x 11.0 mm
