vluncasu/via-oneplus-pad-terminal/hardware/cad/step/optional-probes/Q09_light_transmission_wall_0p8.step

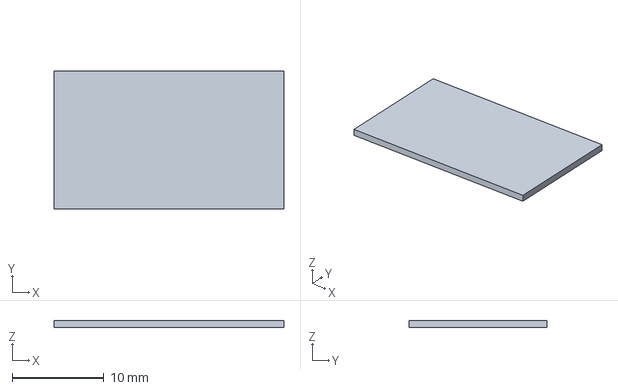
[picture p65: CAD file, 2026-11-08]
hardware/cad/step/optional-probes/Q09_light_transmission_wall_0p8.step
25.0 x 15.0 x 0.8 mm
