vluncasu/via-oneplus-pad-terminal/hardware/print/optional-probes/01x_Q14_tablet_height_gauge_190p41.stl

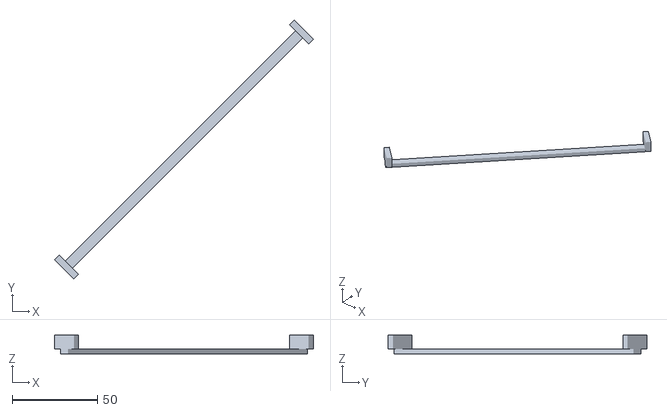
[picture p66: CAD file, 2026-11-08]
hardware/print/optional-probes/01x_Q14_tablet_height_gauge_190p41.stl
151.6 x 151.6 x 11.0
