vluncasu/via-oneplus-pad-terminal/hardware/print/white-petg/01x_H06_upper_rear_service_cover_integrated_locking_pins.stl

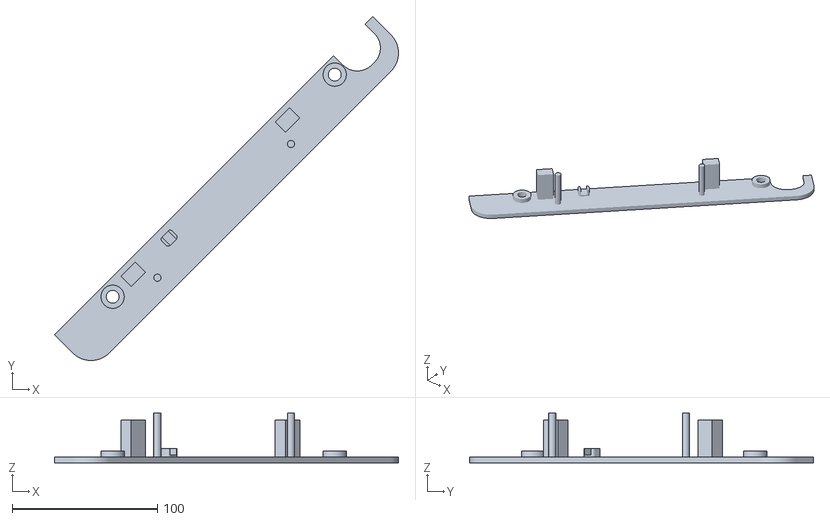
[picture p67: CAD file, 2026-11-08]
hardware/print/white-petg/01x_H06_upper_rear_service_cover_integrated_locking_pins.stl
236.6 x 236.6 x 34.2
