vluncasu/via-oneplus-pad-terminal/hardware/cad/step/optional-probes/Q08_light_transmission_wall_0p6.step

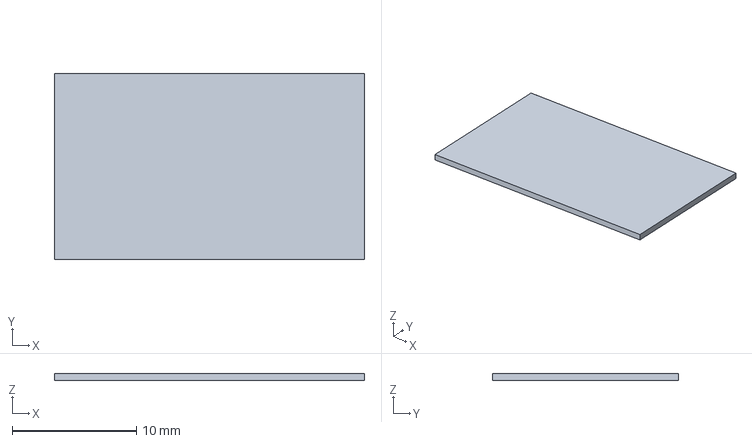
[picture p68: CAD file, 2026-11-08]
hardware/cad/step/optional-probes/Q08_light_transmission_wall_0p6.step
25.0 x 15.0 x 0.6 mm
