vluncasu/via-oneplus-pad-terminal/hardware/print/optional-probes/01x_Q10_light_transmission_wall_1p0.stl

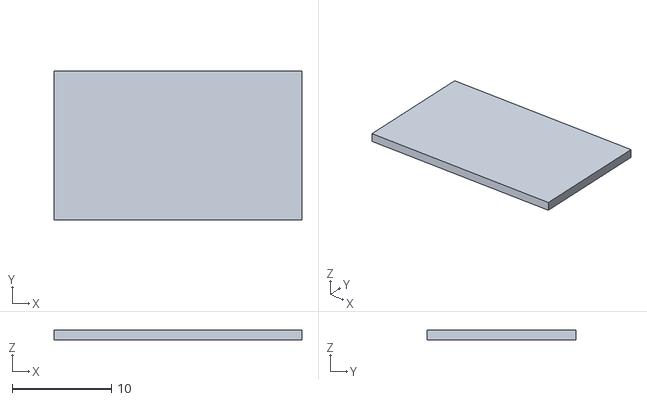
[picture p69: CAD file, 2026-11-08]
hardware/print/optional-probes/01x_Q10_light_transmission_wall_1p0.stl
25.0 x 15.0 x 1.00
