vluncasu/via-oneplus-pad-terminal/hardware/print/optional-probes/01x_Q13_tablet_width_gauge_259p03.stl

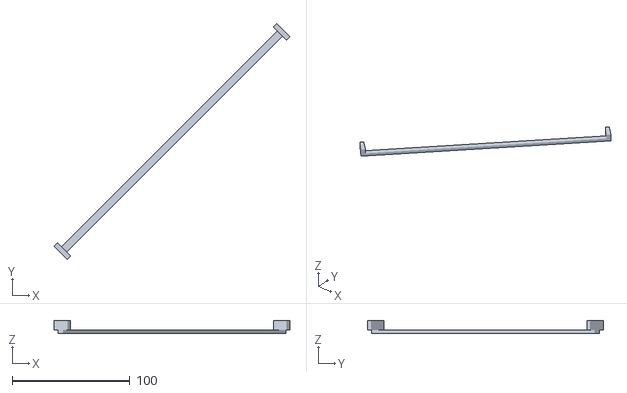
[picture p70: CAD file, 2026-11-08]
hardware/print/optional-probes/01x_Q13_tablet_width_gauge_259p03.stl
200.1 x 200.1 x 11.0
