vluncasu/via-oneplus-pad-terminal/hardware/cad/step/B01_monoblock_base_integrated_light_belt.step

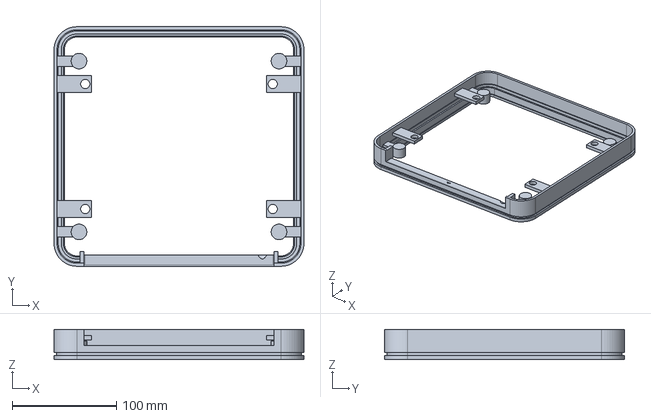
[picture p71: CAD file, 2026-11-08]
hardware/cad/step/B01_monoblock_base_integrated_light_belt.step
240.0 x 230.0 x 29.0 mm
