vluncasu/via-oneplus-pad-terminal/hardware/cad/step/H06_upper_rear_service_cover_integrated_locking_pins.step

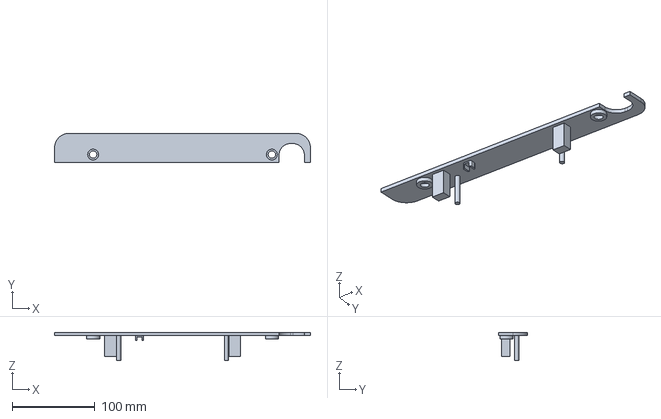
[picture p72: CAD file, 2026-11-08]
hardware/cad/step/H06_upper_rear_service_cover_integrated_locking_pins.step
309.4 x 35.5 x 34.2 mm
