vluncasu/via-oneplus-pad-terminal/hardware/cad/step/optional-probes/Q14_tablet_height_gauge_190p41.step

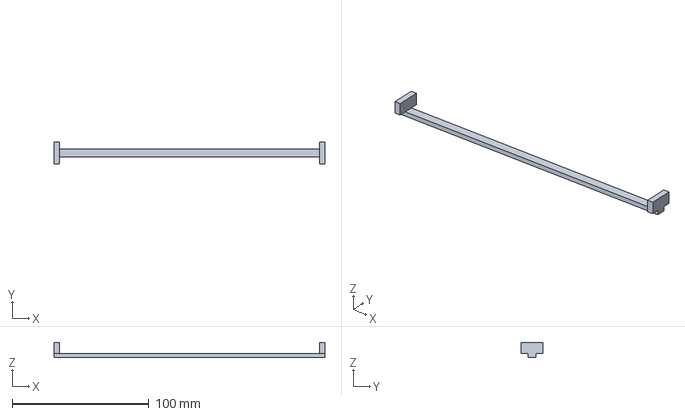
[picture p73: CAD file, 2026-11-08]
hardware/cad/step/optional-probes/Q14_tablet_height_gauge_190p41.step
198.4 x 16.0 x 11.0 mm
