vluncasu/via-oneplus-pad-terminal/hardware/print/optional-probes/01x_Q11_front_camera_clearance_coupon.stl

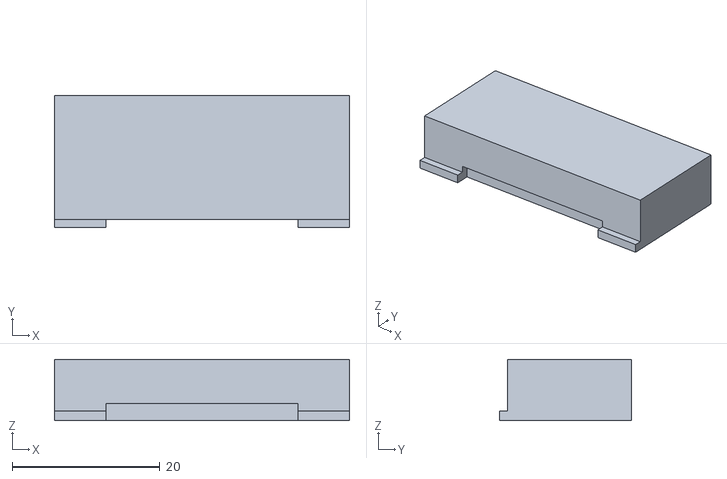
[picture p74: CAD file, 2026-11-08]
hardware/print/optional-probes/01x_Q11_front_camera_clearance_coupon.stl
40.0 x 17.9 x 8.30
