vluncasu/via-oneplus-pad-terminal/hardware/cad/step/H05_sliding_top_tablet_retention_bar.step

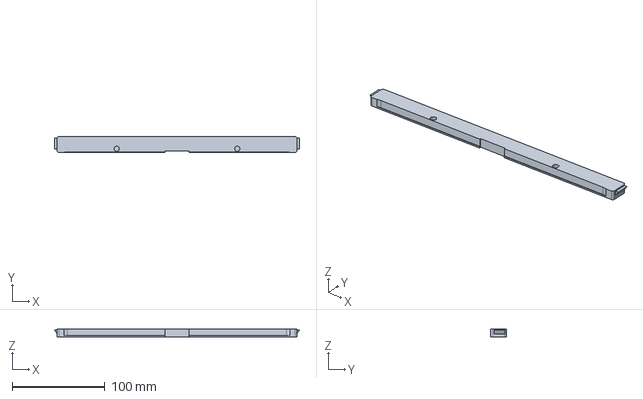
[picture p75: CAD file, 2026-11-08]
hardware/cad/step/H05_sliding_top_tablet_retention_bar.step
264.0 x 17.0 x 8.30 mm
