vluncasu/via-oneplus-pad-terminal/hardware/cad/step/B03_bottom_service_cover.step

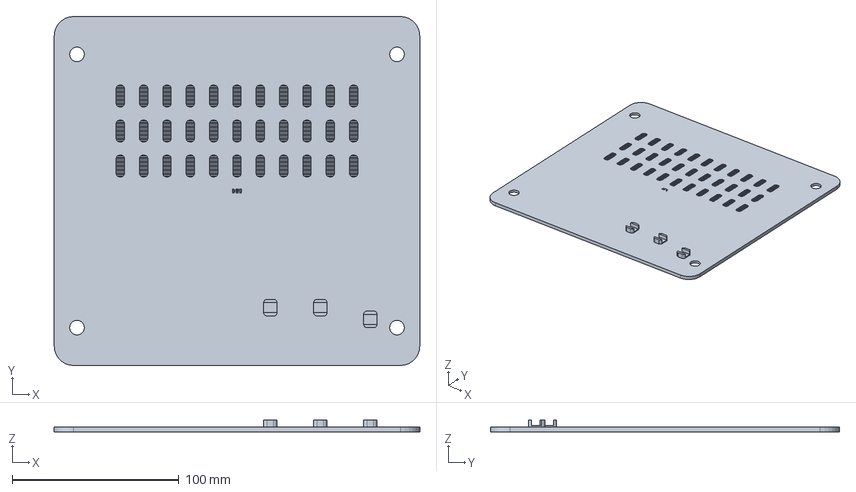
[picture p76: CAD file, 2026-11-08]
hardware/cad/step/B03_bottom_service_cover.step
219.4 x 209.4 x 7.00 mm
