vluncasu/via-oneplus-pad-terminal/hardware/cad/step/H04_lower_structural_rear_cover.step

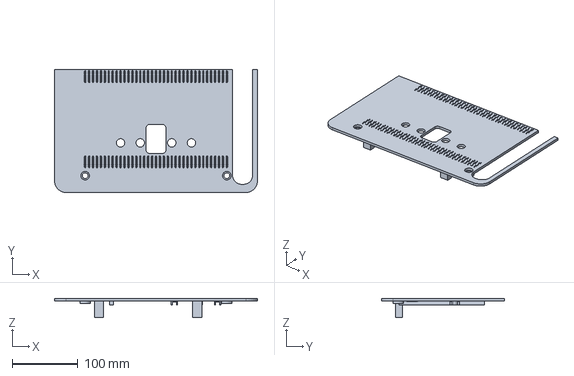
[picture p77: CAD file, 2026-11-08]
hardware/cad/step/H04_lower_structural_rear_cover.step
309.4 x 187.6 x 29.4 mm
