vluncasu/via-oneplus-pad-terminal/(list of files, cad)

Other CAD files:
hardware/cad/assembly/VIA_Terminal_R14_1_Assembly.step
hardware/cad/authoring-history/Terminal_OPD2203_R03/cad/Terminal_OPD2203_R03.FCStd
hardware/cad/authoring-history/Terminal_OPD2203_R04/cad/Terminal_OPD2203_R04.FCStd
hardware/cad/authoring-history/Terminal_OPD2203_R05/cad/Terminal_OPD2203_R05.FCStd
hardware/cad/authoring-history/Terminal_OPD2203_R06/cad/Terminal_OPD2203_R06.FCStd
hardware/cad/authoring-history/Terminal_OPD2203_R09/cad/Terminal_OPD2203_R09.FCStd
hardware/cad/authoring-history/Terminal_OPD2203_R10/cad/Terminal_OPD2203_R10.FCStd
hardware/cad/authoring-history/Terminal_OPD2203_R11/cad/Terminal_OPD2203_R11.FCStd
hardware/cad/authoring-history/Terminal_OPD2203_R12/cad/Terminal_OPD2203_R12.FCStd
hardware/cad/authoring-history/Terminal_OPD2203_R13/cad/Terminal_OPD2203_R13.FCStd
hardware/cad/authoring-history/Terminal_OPD2203_R14/cad/Terminal_OPD2203_R14.FCStd
hardware/print/alternative-thickness/01x_O05_captive_optical_film_0p40mm.stl
hardware/cad/native/terminal-opd2203-r14-baseline.FCStd
hardware/cad/native/via-oneplus-pad-r14-1-film-020.FCStd
hardware/print/optional-probes/01x_Q07_tablet_corner_fit_coupon.stl
hardware/cad/step/O06_flat_back_dummy_sensor_face.step
hardware/cad/step/O01_open_optical_carrier.step
hardware/cad/step/O03_optical_carrier_usb_service_cover.step
hardware/cad/step/O05_captive_optical_film_0p20mm.step
hardware/cad/step/optional-probes/Q10_light_transmission_wall_1p0.step
hardware/cad/step/optional-probes/Q12_usb_plug_pull_through_gauge_16x10x30.step
hardware/print/optional-probes/01x_Q15_led_channel_corner_coupon_8p5.stl
hardware/print/white-petg/01x_B07_integrated_s_stand_and_power_supply_cover.stl
hardware/print/optional-probes/01x_Q09_light_transmission_wall_0p8.stl
hardware/cad/step/P01_recessed_dummy_port_cartridge_and_cable_funnel.step
hardware/cad/step/optional-probes/Q11_front_camera_clearance_coupon.step
hardware/print/optional-probes/01x_Q08_light_transmission_wall_0p6.stl
hardware/cad/revision-archive/R03_Assembly.FCStd
hardware/cad/revision-archive/R04_Assembly.FCStd
hardware/cad/revision-archive/R05_Assembly.FCStd
hardware/cad/revision-archive/R06_Assembly.FCStd
hardware/cad/revision-archive/R09_Assembly.FCStd
hardware/cad/revision-archive/R10_Assembly.FCStd
hardware/cad/revision-archive/R11_Assembly.FCStd
hardware/cad/revision-archive/R12_Assembly.FCStd
hardware/cad/revision-archive/R13_Assembly.FCStd
hardware/cad/revision-archive/R14_Assembly.FCStd
hardware/cad/step/V21_head_mount_screw_D12_P2p5_L12.step
hardware/cad/step/V31_spherical_slotted_screw_foot_D8.step
hardware/cad/step/V41_base_cover_screw_D8_P2p5_L10.step
hardware/cad/step/V51_rear_cover_screw_D8_P2p5_L14.step
hardware/cad/step/V61_usb_cover_screw_D8_P2p5_L16p3.step
hardware/cad/step/assembly-instances/V22_head_mount_screw_D12_P2p5_L12.step
hardware/cad/step/assembly-instances/V23_head_mount_screw_D12_P2p5_L12.step
hardware/cad/step/assembly-instances/V24_head_mount_screw_D12_P2p5_L12.step
hardware/cad/step/assembly-instances/V32_spherical_slotted_screw_foot_D8.step
hardware/cad/step/assembly-instances/V33_spherical_slotted_screw_foot_D8.step
hardware/cad/step/assembly-instances/V34_spherical_slotted_screw_foot_D8.step
hardware/cad/step/assembly-instances/V42_base_cover_screw_D8_P2p5_L10.step
hardware/cad/step/assembly-instances/V43_base_cover_screw_D8_P2p5_L10.step
hardware/cad/step/assembly-instances/V44_base_cover_screw_D8_P2p5_L10.step
hardware/cad/step/assembly-instances/V52_rear_cover_screw_D8_P2p5_L14.step
hardware/cad/step/assembly-instances/V53_rear_cover_screw_D8_P2p5_L14.step
hardware/cad/step/assembly-instances/V54_rear_cover_screw_D8_P2p5_L14.step
hardware/cad/step/assembly-instances/V62_usb_cover_screw_D8_P2p5_L16p3.step
hardware/cad/step/optional-probes/Q01_D12_thread_test_screw.step
hardware/cad/step/optional-probes/Q02_D12_nut_clearance_0p25.step
hardware/cad/step/optional-probes/Q03_D12_nut_clearance_0p35.step
hardware/cad/step/optional-probes/Q04_D12_nut_clearance_0p45.step
hardware/cad/step/optional-probes/Q05_D8_thread_test_screw.step
hardware/cad/step/optional-probes/Q06_D8_nut_clearance_0p30.step
hardware/print/optional-probes/01x_Q01_D12_thread_test_screw.stl
hardware/print/optional-probes/01x_Q02_D12_nut_clearance_0p25.stl
hardware/print/optional-probes/01x_Q03_D12_nut_clearance_0p35.stl
hardware/print/optional-probes/01x_Q04_D12_nut_clearance_0p45.stl
hardware/print/optional-probes/01x_Q05_D8_thread_test_screw.stl
hardware/print/optional-probes/01x_Q06_D8_nut_clearance_0p30.stl
hardware/print/white-petg/02x_V61-V62_usb_cover_screw_D8_P2p5_L16p3.stl
hardware/print/white-petg/04x_V21-V22-V23-V24_head_mount_screw_D12_P2p5_L12.stl
hardware/print/white-petg/04x_V31-V32-V33-V34_spherical_slotted_screw_foot_D8.stl
hardware/print/white-petg/04x_V41-V42-V43-V44_base_cover_screw_D8_P2p5_L10.stl
hardware/print/white-petg/04x_V51-V52-V53-V54_rear_cover_screw_D8_P2p5_L14.stl
media/via-oneplus-pad-r14-1-assembled.blend
