vluncasu/via-oneplus-pad-terminal/docs/documentation-changelog.md

# Release Notes

## R14.1 hardware files

- Clean 30-component FreeCAD assembly and complete assembly STEP.
- Seventeen unique required component families, with quantity-named STLs separated by filament color.
- Current O05 optical film at 0.20 mm; 0.40 mm retained as an alternative.
- One-piece integrated S stand and upper power-volume cover, internal cable route, integrated LED seating and upper-rear tablet service access.
- Native earlier revisions retained for comparison.

## Guides and illustrations

The documentation includes a part catalog, printing and assembly instructions, CAD editing guide, LED/wiring notes and practical fit checks. Thirty-three engineering illustrations show component relationships and internal sections; four studio views present the assembled terminal.

The illustrated handbook and engineering design report accompany the files. The normal assembly and studio scenes can be opened directly in Blender.

## Android 1.0.5

VIA Terminal and VIA Mobile use local named profiles and QR/BLE confirmation. Bluetooth retry and Mobile Back navigation are covered by the regression tests. Installers are in the [application release](https://github.com/vluncasu/via-oneplus-pad-terminal/releases/tag/v1.0.5).
