vluncasu/via-oneplus-pad-terminal/(commit log)

2026-11-08 Publish VIA offline Android apps and OnePlus Pad enclosure R14.1
    [01x_B01_monoblock_base_integrated_light_belt.stl, 01x_B03_bottom_service_cover.stl, 01x_B07_integrated_s_stand_and_power_supply_cover.stl, 01x_H01_structural_front_frame_integrated_led_channel.stl, 01x_H04_lower_structural_rear_cover.stl, 01x_H05_sliding_top_tablet_retention_bar.stl, 01x_H06_upper_rear_service_cover_integrated_locking_pins.stl, 01x_O01_open_optical_carrier.stl]
2026-11-08 Deliver native and STEP editing files without construction source
    [O05_captive_optical_film_0p40mm_baseline.step, Q01_D12_thread_test_screw.step, Q02_D12_nut_clearance_0p25.step, Q03_D12_nut_clearance_0p35.step, Q04_D12_nut_clearance_0p45.step, Q05_D8_thread_test_screw.step, Q06_D8_nut_clearance_0p30.step, Q07_tablet_corner_fit_coupon.step]
2026-11-08 Present VIA with refined studio renders on the landing page
2026-11-08 Simplify the CAD handoff to editable models, print files and practical guides
    [B01.stl, B03.stl, B07.stl, H01.stl, H04.stl, H05.stl, H06.stl, O01.stl]
